CornevanDijk/ATX-Breakout-Board/ATX PSU Breakout Mini.brd

## EAGLE design ATX PSU Breakout Mini.brd (2015-01-02)

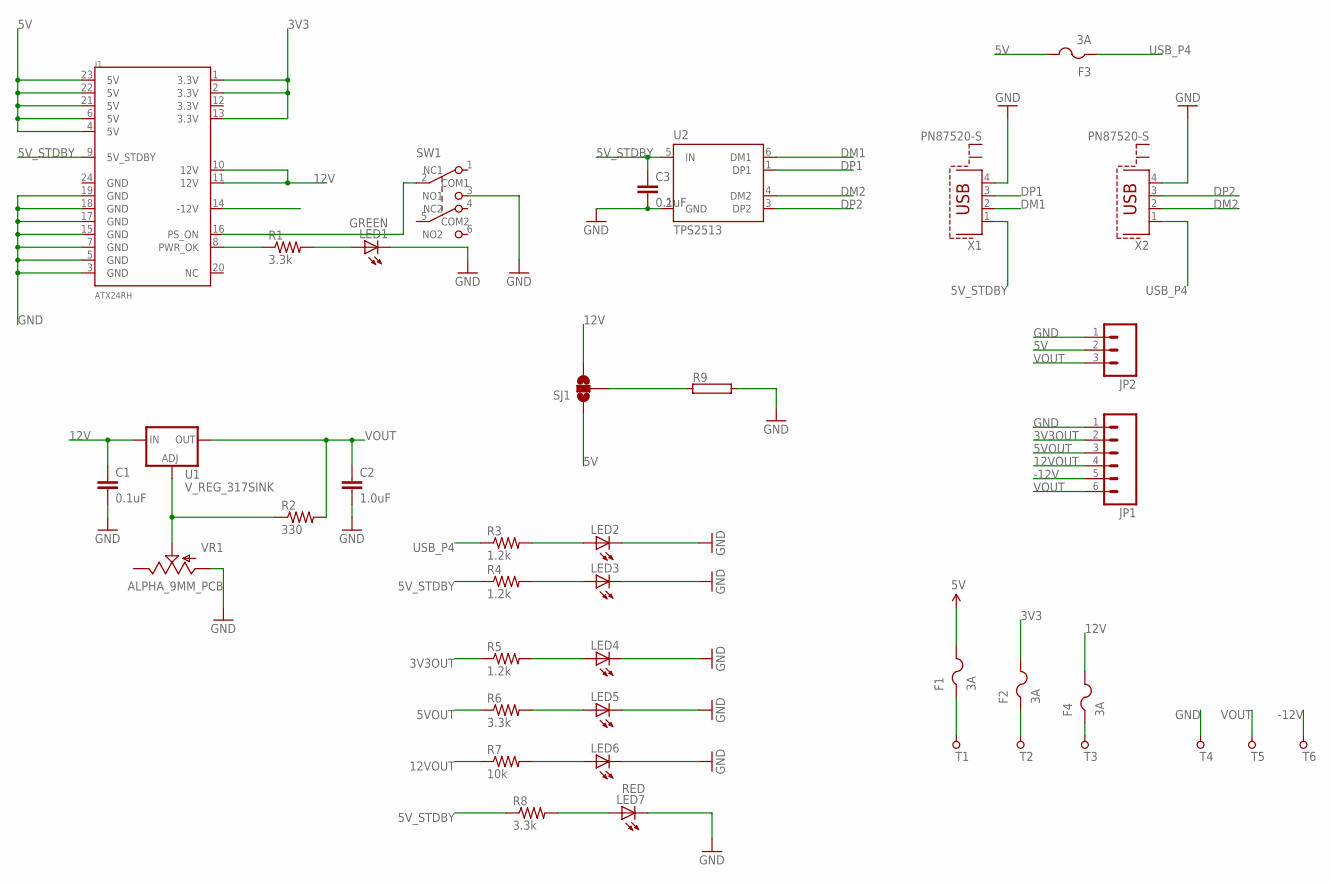
[picture p1: schematic ATX PSU Breakout Mini.sch]

Parts:
C1, C3: 0.1uF; 0805
C2: 1.0uF; 0805
F1, F2, F3, F4: 3A; 1812
J1: ATX24RH; ATX24_RIGHT_ANGLE
JP1: M06LOCK; 1X06_LOCK
JP2: M03PTH; 1X03
LED1: GREEN; CHIPLED_0805
LED2, LED3, LED4, LED5, LED6: LEDCHIPLED_0805; CHIPLED_0805
LED7: RED; CHIPLED_0805
R1, R6, R8: 3.3k; 0805
R2: 330; 0805
R3, R4, R5: 1.2k; 0805
R7: 10k; 0805
R9: RKH214-8; KH214-8
SJ1: SOLDERJUMPER_2WAYS; SJ_3
SW1: SW_PUSH_DPDT; SW_PUSH_BUTTON_MINI
T1: 5V; PAD_ROUND_4.1MM
T2: 3V3; PAD_ROUND_4.1MM
T3: 12V; PAD_ROUND_4.1MM
T4: GND; PAD_ROUND_4.1MM
T5: ADJ; PAD_ROUND_4.1MM
T6: -12V; PAD_ROUND_4.1MM
U1: V_REG_317SINK; TO220-ADJ
U2: TPS2513; SOT23-6
VR1: ALPHA_9MM_PCB
X1, X2: PN87520-S

Connections:
3V3: F2.2, J1.1 (3.3V), J1.2 (3.3V), J1.13 (3.3V)
3V3OUT: F2.1, JP1.2, R5.1, T2.P
5V: F1.2, F3.2, J1.4 (5V), J1.6 (5V), J1.21 (5V), J1.22 (5V), J1.23 (5V), JP2.2, SJ1.1
5VOUT: F1.1, JP1.3, R6.1, T1.P
5V_STDBY: C3.1, J1.9 (5V_STDBY), R4.1, R8.1, U2.5 (IN), X1.1
12V: C1.1, F4.2, J1.10 (12V), J1.11 (12V), SJ1.3, U1.IN
12VOUT: F4.1, JP1.4, R7.1, T3.P
-12V: J1.14 (-12V), JP1.5, T6.P
DM1: U2.6 (DM1), X1.2
DM2: U2.4 (DM2), X2.2
DP1: U2.1 (DP1), X1.3
DP2: U2.3 (DP2), X2.3
GND: C1.2, C2.2, C3.2, J1.3 (GND), J1.5 (GND), J1.7 (GND), J1.15 (GND), J1.17 (GND), J1.18 (GND), J1.19 (GND), JP1.1, JP2.1, LED1.C, LED2.C, LED3.C, LED4.C, LED5.C, LED6.C, LED7.C, R9.2, SW1.3 (NO1), T4.P, U2.2 (GND), VR1.1 (A), X1.4, X2.4
unnamed: J1.8 (PWR_OK), R1.1
unnamed: LED1.A, R1.2
unnamed: R9.1, SJ1.2
unnamed: R2.1, U1.ADJ, VR1.2 (S)
unnamed: J1.16 (PS_ON), SW1.2 (COM1)
unnamed: LED7.A, R8.2
unnamed: LED3.A, R4.2
unnamed: LED2.A, R3.2
unnamed: LED4.A, R5.2
unnamed: LED5.A, R6.2
unnamed: LED6.A, R7.2
USB_P4: F3.1, R3.1, X2.1
VOUT: C2.1, JP1.6, JP2.3, R2.2, T5.P, U1.OUT

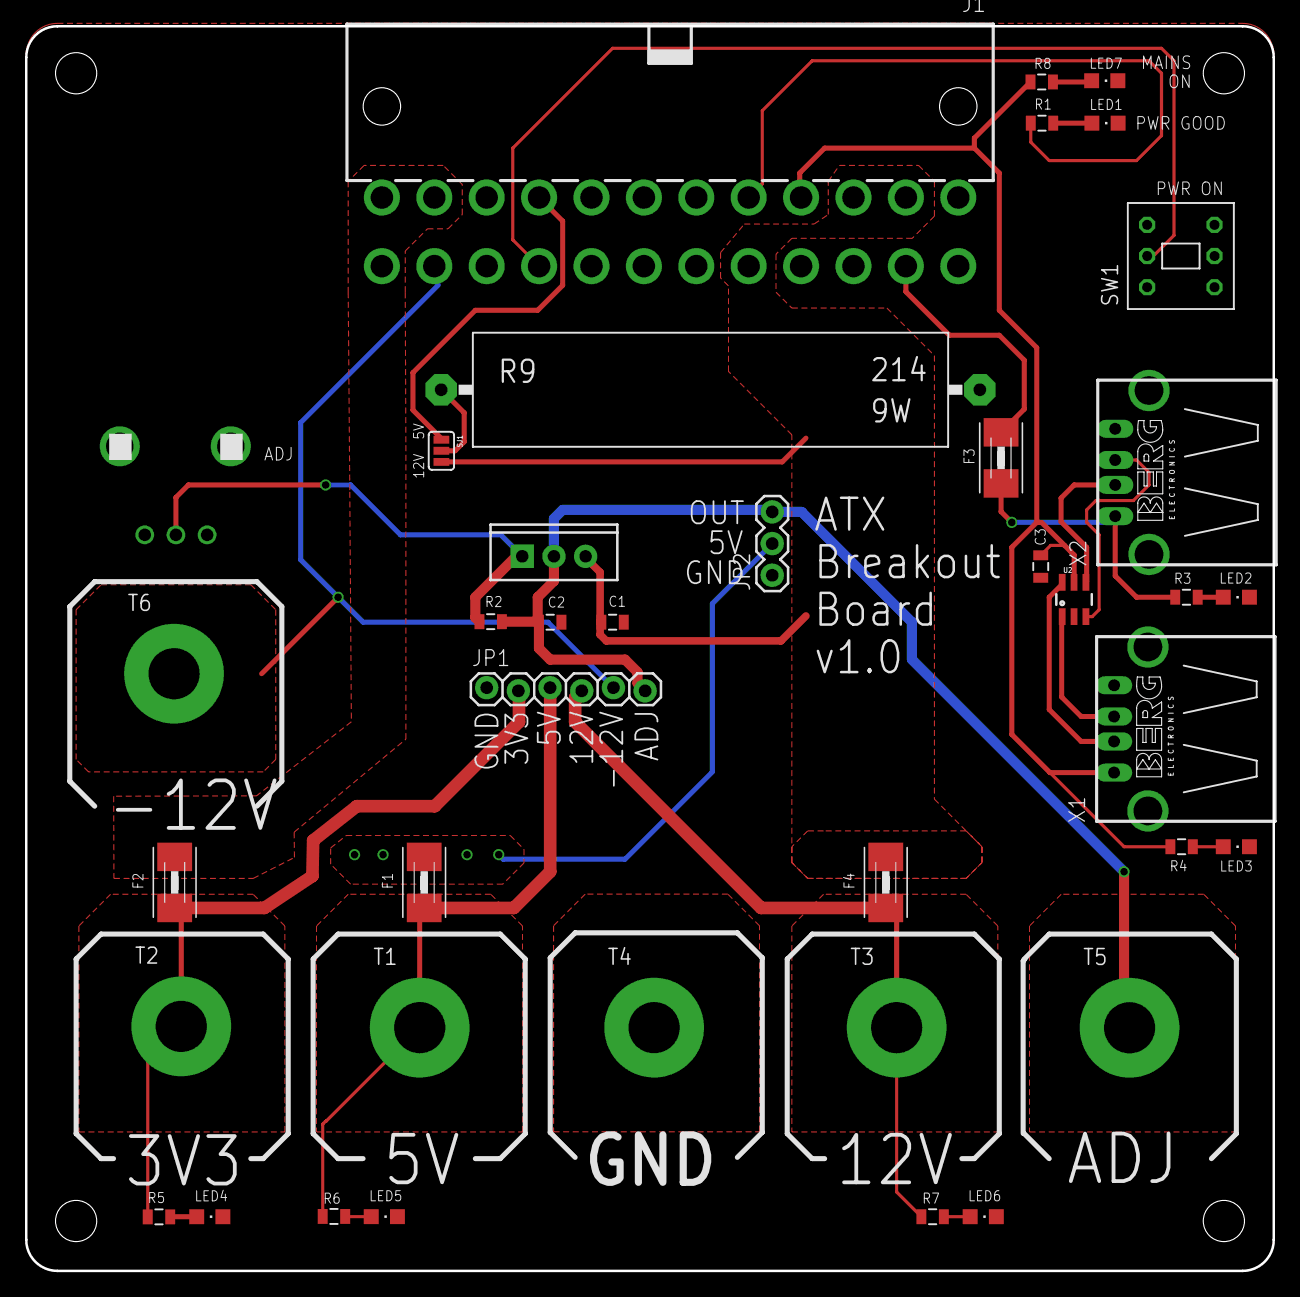
[picture p2: board ATX PSU Breakout Mini.brd from above]

Board: 2 copper layers, 100.0 x 99.8 mm, 43 parts (0 on the bottom side), 26 nets.

Other parts of the board:
U$1, U$2, U$3, U$4: STAND-OFF
